oyeniyihakeem08-blip/Night-light-PCB-prototype/Night light PCB (Kicad and production files)/Design filess/Night light PCB BOM .csv

Reference | Value | DNP | Exclude from BOM | Footprint | LCSC Part #
H1,H2,H3,H4,H5 | MountingHole |  |  | MountingHole:MountingHole_3.2mm_M3
J2,J3 | Conn_ARM_SWD_TagConnect_TC2030 |  |  | Connector:Tag-Connect_TC2030-IDC-FP_2x03_P1.27mm_Vertical
J4,J5 | Conn_01x01_Pin |  |  | TestPoint:TestPoint_Keystone_5010-5014_Multipurpose
R4 | NTC |  |  | Resistor_SMD:R_0402_1005Metric
TP1 | LDO_IN |  |  | TestPoint:TestPoint_Pad_D4.0mm
U3,U5,U7,U8,U9,U10,U11,U12,U13 | mouse bite |  |  | mouse bite:mouse-bite-2mm-4mm
LED1,LED2,LED3,LED4,LED5,LED6 | SPMWH1228MD5WATUVK |  |  | LED:SPMWH1228MD5WATUVK | 1510-SPMWH1228MD7WATUVKTR-ND
BT1 | Battery |  |  | Battery:BatteryHolder_Keystone_2468_2xAAA | BC2AAAPC
C39,C55 | 1.5pf |  |  | Capacitor_SMD:C_0402_1005Metric | C1552
C40,C54 | 4.7pf |  |  | Capacitor_SMD:C_0402_1005Metric | C1569
IC1,IC5 | NRF24L01P-R |  |  | nRF24L01P:QFN50P400X400X95-21N-D | C8791
Y1,Y2 | crystal |  |  | crystal:X322516MOB4SI | C12668
Q1,Q3 | AO3407A |  |  | PMOS A03407:SOT95P280X125-3N | C15155
C31,C51 | 10nf |  |  | Capacitor_SMD:C_0402_1005Metric | C15195
Q2,Q4 | AO3400A |  |  | Package_TO_SOT_SMD:SOT-23 | C20917
R36 | 180K |  |  | Resistor_SMD:R_0402_1005Metric | C25760
C12 | 1uf |  |  | Capacitor_SMD:C_0805_2012Metric | C28323
C1 | 1uf |  |  | Capacitor_SMD:C_0402_1005Metric | C29266
C3,C6 | 100nf |  |  | Capacitor_SMD:C_0805_2012Metric | C49678
C7 | 0.1uf |  |  | Capacitor_SMD:C_0805_2012Metric | C49678
U1 | BQ24074RGT |  |  | Package_DFN_QFN:VQFN-16-1EP_3x3mm_P0.5mm_EP1.6x1.6mm | C54313
C36,C53 | 100nf |  |  | Capacitor_SMD:C_0402_1005Metric | C60474
R2,R5,R8,R9,R11,R16,R17,R18,R22,R40,R48,R49,R50,R51 | 10k |  |  | Resistor_SMD:R_0402_1005Metric | C60490
R19 | 120k |  |  | Resistor_SMD:R_0402_1005Metric | C60490
R10,R13,R29 | 100k |  |  | Resistor_SMD:R_0402_1005Metric | C60491
IC2 | TLV3012AIDBVTG4 |  |  | TLV3012:SOT95P280X145-6N | C62505
C28,C50 | 1nf |  |  | Capacitor_SMD:C_0402_1005Metric | C76947
L6,L8 | 2.7nH |  |  | Inductor_SMD:L_0402_1005Metric | C77108
R6,R21 | 22k |  |  | Resistor_SMD:R_0402_1005Metric | C82868
R52 | 330r |  |  | Resistor_SMD:R_0402_1005Metric | C84256
L4,L7 | 8.2nH |  |  | Inductor_SMD:L_0402_1005Metric | C84404
C2 | 1nf |  |  | Capacitor_SMD:C_0805_2012Metric | C94121
C14 | 10uf |  |  | Capacitor_SMD:C_0805_2012Metric | C95841
C5,C8,C9,C11 | 4.7uf |  |  | Capacitor_SMD:C_0805_2012Metric | C98192
R7 | 4k7 |  |  | Resistor_SMD:R_0402_1005Metric | C105871
R15 | 100r |  |  | Resistor_SMD:R_0402_1005Metric | C106232
R38 | 100R |  |  | Resistor_SMD:R_0402_1005Metric | C106232
C16,C47 | 33nf |  |  | Capacitor_SMD:C_0402_1005Metric | C106862
R20 | R_Photo |  |  | OptoDevice:R_LDR_5.0x4.1mm_P3mm_Vertical | C125627
C10 | 220uf |  |  | Capacitor_SMD:C_Elec_6.3x7.7 | C125977
F1 | JFC2410-1100TS |  |  | FUSE:FUSC10131X330N | C136380
R27,R35 | 6.2k |  |  | Resistor_SMD:R_0402_1005Metric | C137946
R39 | 470k |  |  | Resistor_SMD:R_0402_1005Metric | C137976
R41,R42,R43,R44,R45,R46 | 33R |  |  | Resistor_SMD:R_0805_2012Metric | C138002
R1 | 2.7K |  |  | Resistor_SMD:R_0402_1005Metric | C138017
R14,R26,R32,R33,R47 | 1M |  |  | Resistor_SMD:R_0402_1005Metric | C138033
R23,R24,R25,R28,R30 | 18k |  |  | Resistor_SMD:R_0402_1005Metric | C138044
FL2 | UU9.8-10MH |  |  | 10MH CHOKE:UU9810MH | C148474
J1 | Battery |  |  | Connector_JST:JST_EH_B2B-EH-A_1x02_P2.50mm_Vertical | C160262
R3 | 1.8K |  |  | Resistor_SMD:R_0402_1005Metric | C163481
R31 | 2.2M |  |  | Resistor_SMD:R_0402_1005Metric | C203143
PS1 | HLK-5M05 |  |  | Converter_ACDC:Converter_ACDC_Hi-Link_HLK-5Mxx | C209907
C23,C25,C48,C49 | 22pf |  |  | Capacitor_SMD:C_0402_1005Metric | C277482
C37 | 103pf |  |  | Capacitor_SMD:C_0402_1005Metric | C327009
U4 | TLV75533PDBV |  |  | Package_TO_SOT_SMD:SOT-23-5 | C404027
R34 | 3.3M |  |  | Resistor_SMD:R_0402_1005Metric | C482174
U2 | ATtiny1616-S |  |  | Package_SO:SOIC-20W_7.5x12.8mm_P1.27mm | C614136
C34,C44,C45 | 470pf |  |  | Capacitor_SMD:C_0402_1005Metric | C701296
C42,C56 | 1pf |  |  | Capacitor_SMD:C_0402_1005Metric | C710646
IC4 | STM32G031K8T6TR |  |  | STM32:QFP80P900X900X160-32N | C724044
VR1 | PVG3A103C01R00 |  |  | 10k trimmer:PVG3A103C01R00 | C780220
RV1 | Varistor |  |  | Varistor:RV_Disc_D12mm_W4.5mm_P7.5mm | C2839517
C19 | 10uf |  |  | Capacitor_SMD:C_1210_3225Metric | C2918502
C43,C52 | 2.2nf |  |  | Capacitor_SMD:C_0402_1005Metric | C2987940
R37 | 4.7M |  |  | Resistor_SMD:R_0402_1005Metric | C3013173
R12 | 174k |  |  | Resistor_SMD:R_0402_1005Metric | C4214842
S1,S2,S3 | 1301.9314.24 |  |  | Switch:1301931424 | C4364459
C21,C26,C35,C41 | 47uf |  |  | Capacitor_SMD:C_1210_3225Metric | C5440143
L5,L9 | 3.9nH |  |  | Inductor_SMD:L_0402_1005Metric | C5452416
IC3 | BISS0001 |  |  | BISS0001:SOIC127P600X160-16N | C18164474
C22 | 510pf |  |  | Capacitor_SMD:C_0402_1005Metric | C18185763
D1 | LED |  |  | LED_SMD:LED_0402_1005Metric | C21260817
C30,C38 | 56nf |  |  | Capacitor_SMD:C_0402_1005Metric | C36911349
C46 | 56nF |  |  | Capacitor_SMD:C_0402_1005Metric | C36911349
C4 | 0.1 |  |  | Capacitor_THT:C_Rect_L13.0mm_W8.0mm_P10.00mm_FKS3_FKP3_MKS4 | C46638858
U6 | PIS-209S |  |  | PIS209S:PIS209S | https://www.jotrin.com/product/parts/PIS209S
