oyeniyihakeem08-blip/Night-light-PCB-prototype/3D Model/2468.step

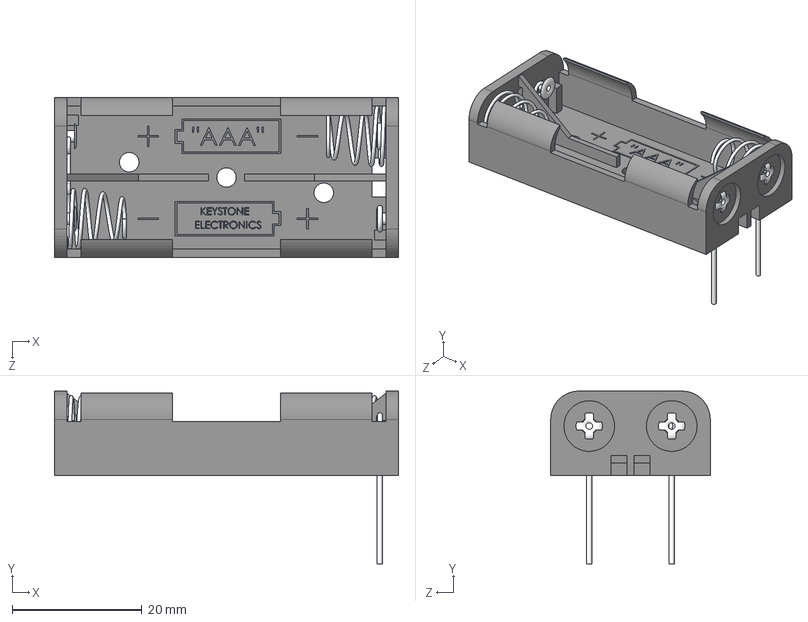
[picture p8: CAD file, 2026-05-13]
3D Model/2468.step
53.0 x 26.6 x 24.6 mm
