oyeniyihakeem08-blip/Night-light-PCB-prototype/Design filess/Night light PCB 3D model/Night Light board.step

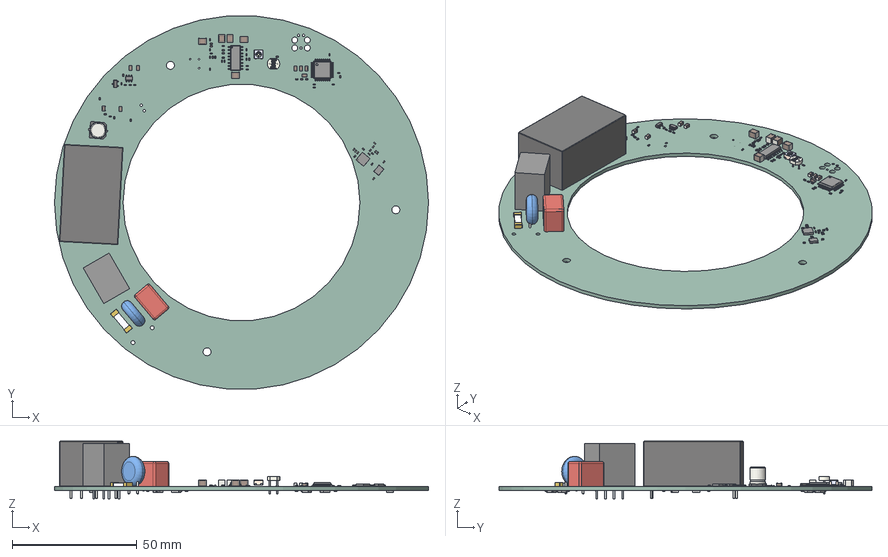
[picture p9: CAD file, 2026-05-13]
Design filess/Night light PCB 3D model/Night Light board.step
150.0 x 149.6 x 23.1 mm
R_0402_1005Metric x 40
C_0402_1005Metric x 19
L_0402_1005Metric x 3
C_0805_2012Metric x 8
Converter_ACDC_Hi-Link_HLK-5Mxx
C_1210_3225Metric x 5
ThermalPin
PinsArrayLR x 3
PinsArrayTB x 2
BODY-SOT
LEAD-SOT x 6
RV_Disc_D12mm_W4.5mm_P7.5mm
Leads x 4
C_Elec_6.3x7.7
Pins
10k pot PVG3A103C01R00
SOT-23
fuse SF-3812TL100T-2
C_Rect_L13.0mm_W8.0mm_P10.00mm_FKS3_FKP3_MKS4
R_LDR_5.0x4.1mm_P3mm_Vertical
LED SPMWH1228MD5WATUVK x 6
Night light PCB_PCB
