oyeniyihakeem08-blip/Night-light-PCB-prototype/Night light PCB (Kicad and production files)/Design filess/Night light PCB 3D model/Night Light remote board.step

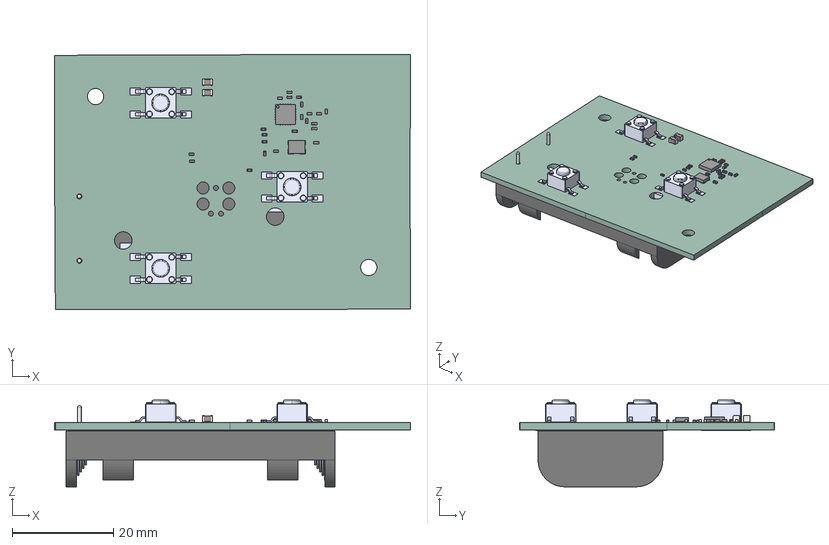
[picture p10: CAD file, 2026-05-13]
Night light PCB (Kicad and production files)/Design filess/Night light PCB 3D model/Night Light remote board.step
70.2 x 50.2 x 17.1 mm
L_0402_1005Metric x 3
R_0402_1005Metric x 9
Pins
C_0402_1005Metric x 10
Switch 1301.9314.24 x 3
C_0805_2012Metric x 2
ThermalPin
PinsArrayLR
PinsArrayTB
BatteryHolder_Keystone_2468_2xAAA
Night light PCB_PCB
