oyeniyihakeem08-blip/Night-light-PCB-prototype/3D Model/fuse  SF-3812TL100T-2.stp

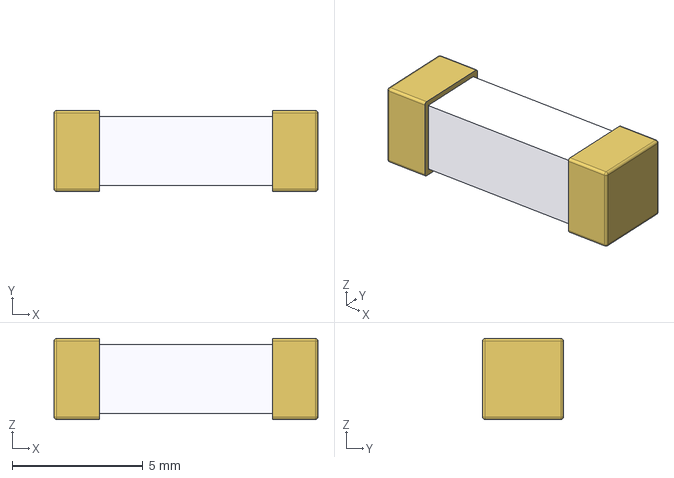
[picture p11: CAD file, 2026-04-28]
3D Model/fuse SF-3812TL100T-2.stp
10.1 x 3.10 x 3.10 mm
