oyeniyihakeem08-blip/Night-light-PCB-prototype/Night light PCB (Kicad and production files)/Design filess/Night light PCB 3D model/Night light PCB.step

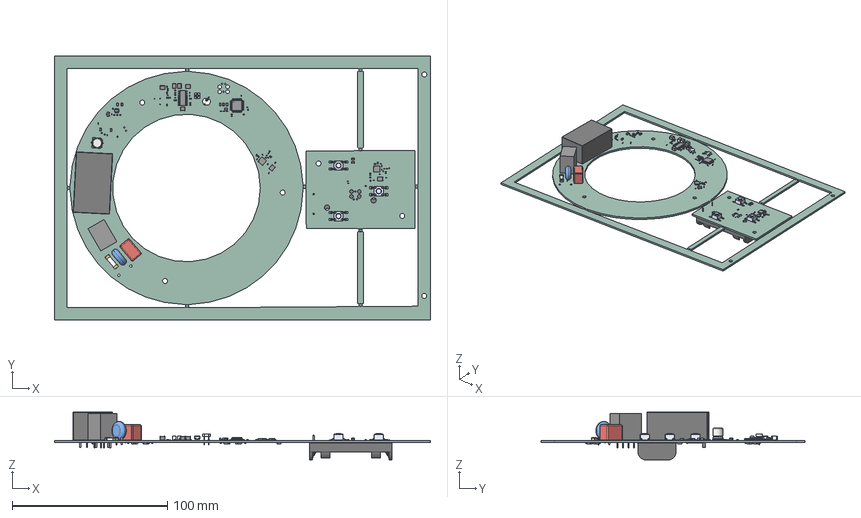
[picture p12: CAD file, 2026-04-28]
Night light PCB (Kicad and production files)/Design filess/Night light PCB 3D model/Night light PCB.step
242.1 x 170.0 x 30.9 mm
R_0402_1005Metric x 49
C_0402_1005Metric x 29
L_0402_1005Metric x 6
C_0805_2012Metric x 10
Converter_ACDC_Hi-Link_HLK-5Mxx
C_1210_3225Metric x 5
ThermalPin x 2
PinsArrayLR x 4
PinsArrayTB x 3
Pins x 2
BODY-SOT
LEAD-SOT x 6
Switch 1301.9314.24 x 3
RV_Disc_D12mm_W4.5mm_P7.5mm
Leads x 4
C_Elec_6.3x7.7
10k pot PVG3A103C01R00
SOT-23
fuse SF-3812TL100T-2
C_Rect_L13.0mm_W8.0mm_P10.00mm_FKS3_FKP3_MKS4
R_LDR_5.0x4.1mm_P3mm_Vertical
LED SPMWH1228MD5WATUVK x 6
BatteryHolder_Keystone_2468_2xAAA
Night light PCB_PCB
