oyeniyihakeem08-blip/Night-light-PCB-prototype/3D Model/STM32G031K8T6TR.stp

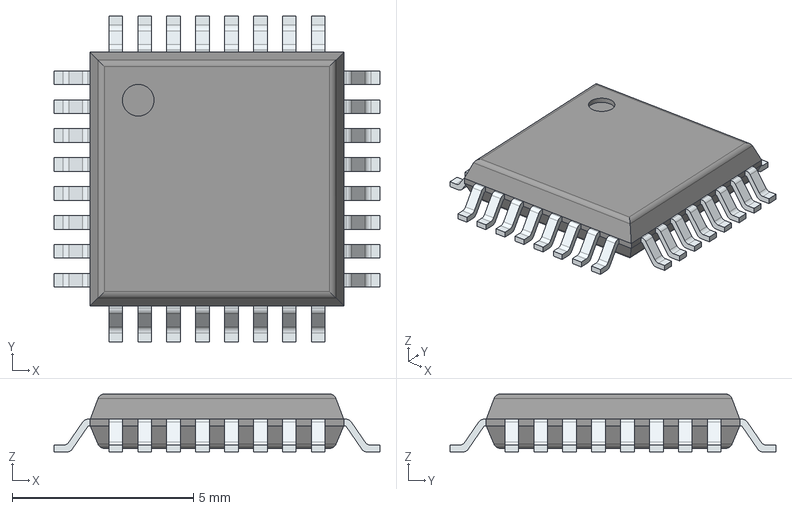
[picture p13: CAD file, 2026-04-28]
3D Model/STM32G031K8T6TR.stp
9.00 x 9.00 x 1.60 mm
PinsArrayLR
PinsArrayTB
