oyeniyihakeem08-blip/Night-light-PCB-prototype/3D Model/NRF24L01P-R.stp

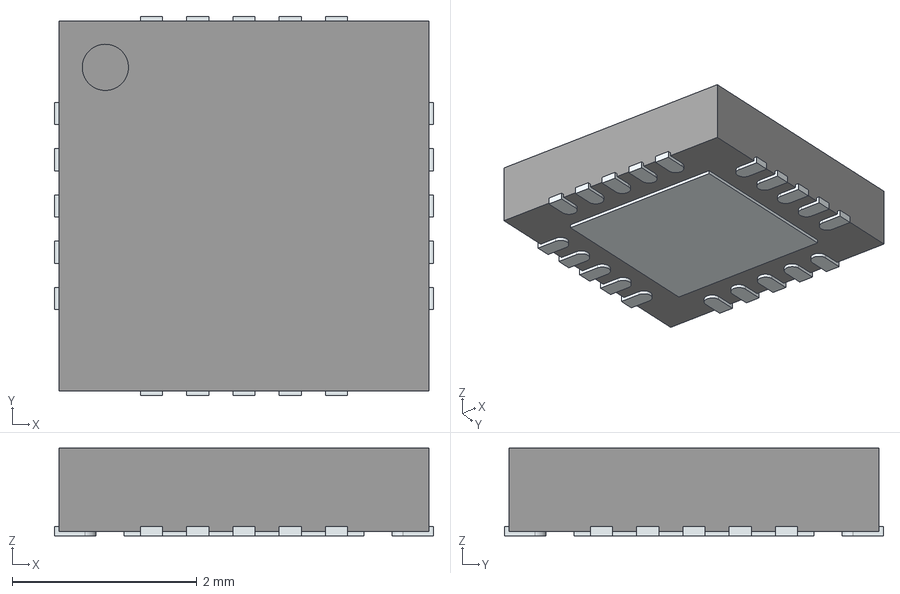
[picture p14: CAD file, 2026-04-28]
3D Model/NRF24L01P-R.stp
4.10 x 4.10 x 0.95 mm
ThermalPin
PinsArrayLR
PinsArrayTB
