oyeniyihakeem08-blip/Night-light-PCB-prototype/3D Model/Switch  1301.9314.24.stp

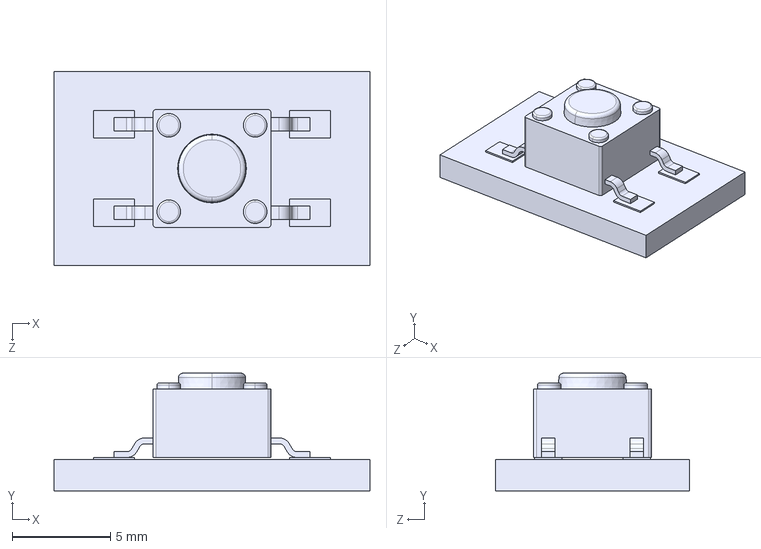
[picture p15: CAD file, 2026-04-28]
3D Model/Switch 1301.9314.24.stp
16.1 x 6.00 x 9.90 mm
