oyeniyihakeem08-blip/Night-light-PCB-prototype/3D Model/TLV3012AIDBVTG4.stp

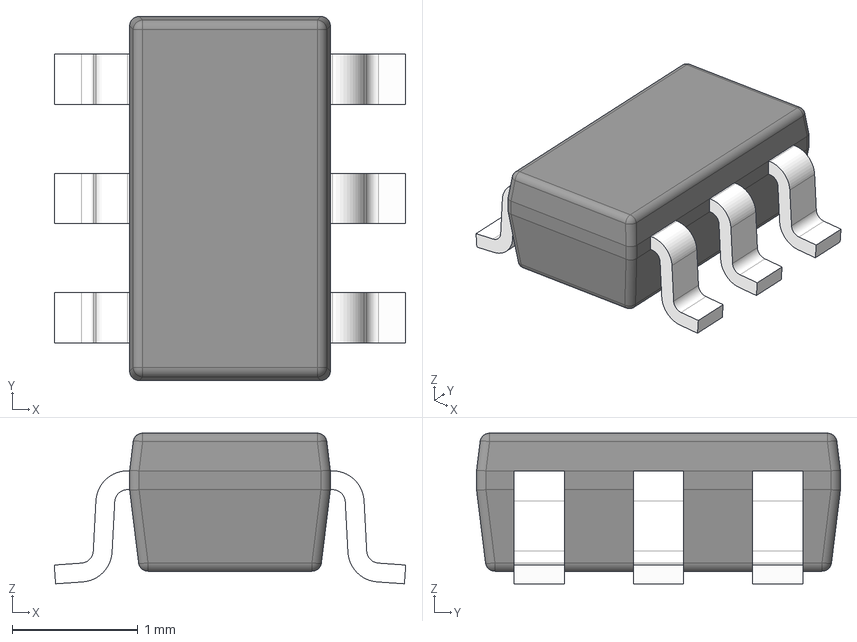
[picture p16: CAD file, 2026-04-28]
3D Model/TLV3012AIDBVTG4.stp
2.80 x 2.90 x 1.20 mm
BODY-SOT
LEAD-SOT x 6
