oyeniyihakeem08-blip/Night-light-PCB-prototype/3D Model/crystal  X322516MOB4SI.stp

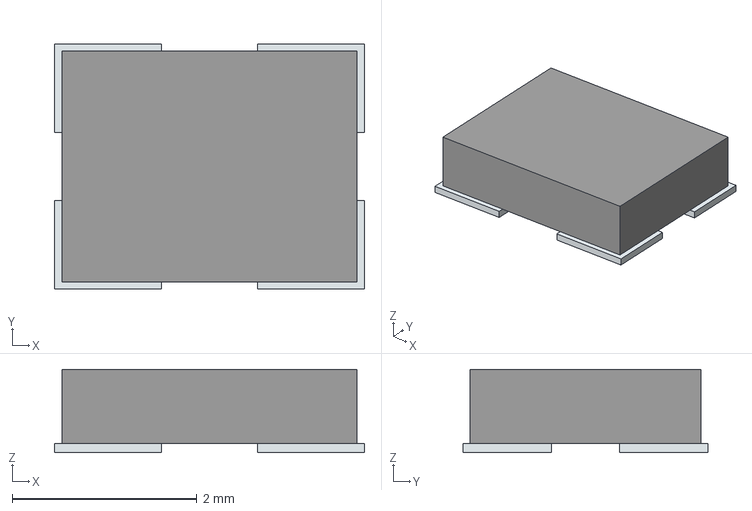
[picture p17: CAD file, 2026-04-28]
3D Model/crystal X322516MOB4SI.stp
3.36 x 2.66 x 0.9 mm
Pins
