oyeniyihakeem08-blip/Night-light-PCB-prototype/3D Model/UU9.8-10MH.stp

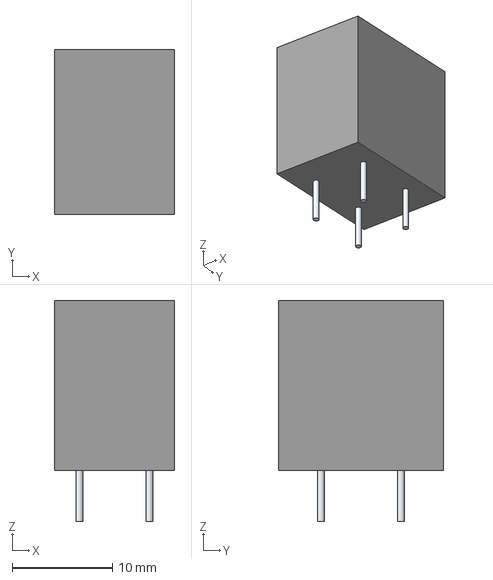
[picture p18: CAD file, 2026-04-28]
3D Model/UU9.8-10MH.stp
12.0 x 16.5 x 22.1 mm
Leads x 4
