oyeniyihakeem08-blip/Night-light-PCB-prototype/3D Model/LED  SPMWH1228MD5WATUVK.stp

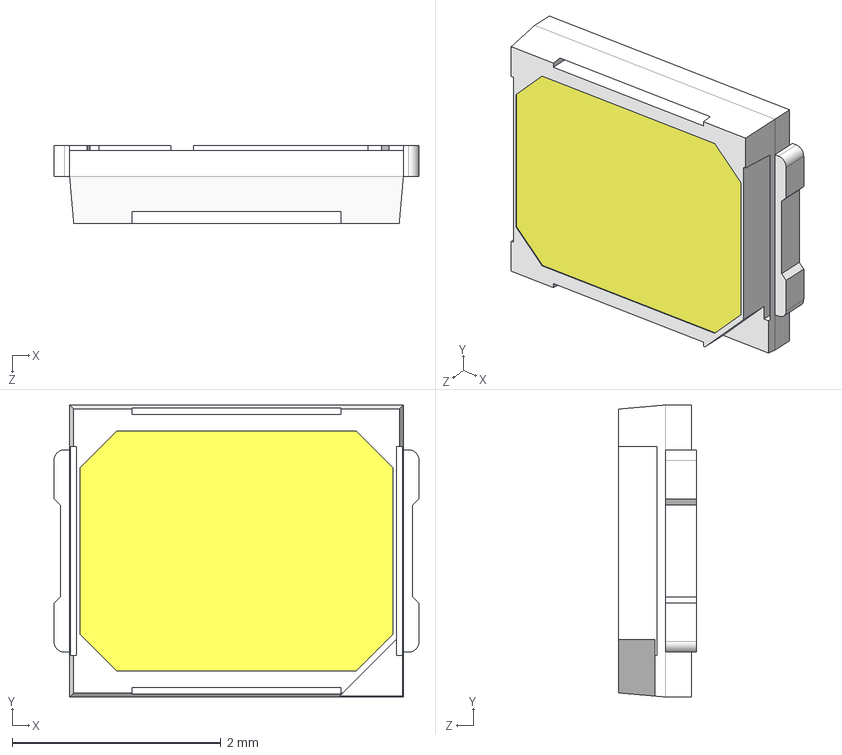
[picture p19: CAD file, 2026-04-28]
3D Model/LED SPMWH1228MD5WATUVK.stp
3.50 x 2.80 x 0.75 mm
