oyeniyihakeem08-blip/Night-light-PCB-prototype/3D Model/10k pot PVG3A103C01R00.stp

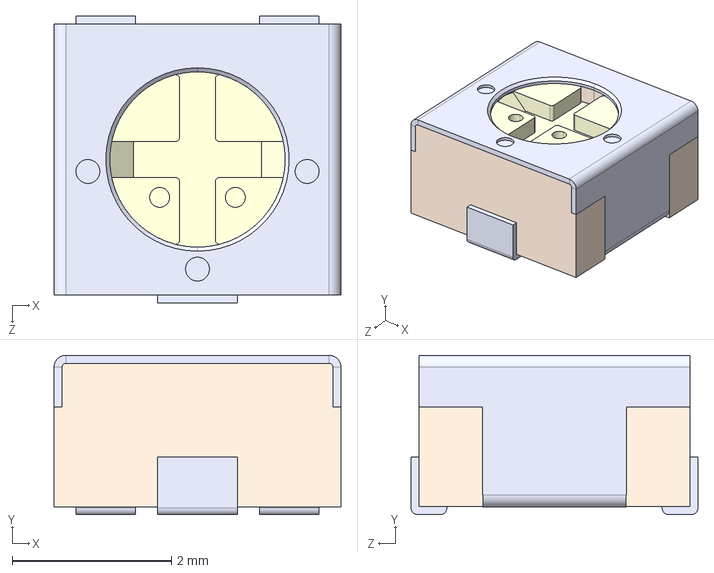
[picture p20: CAD file, 2026-04-22]
3D Model/10k pot PVG3A103C01R00.stp
3.60 x 2.00 x 3.60 mm
