oyeniyihakeem08-blip/Night-light-PCB-prototype/3D Model/BISS0001.stp

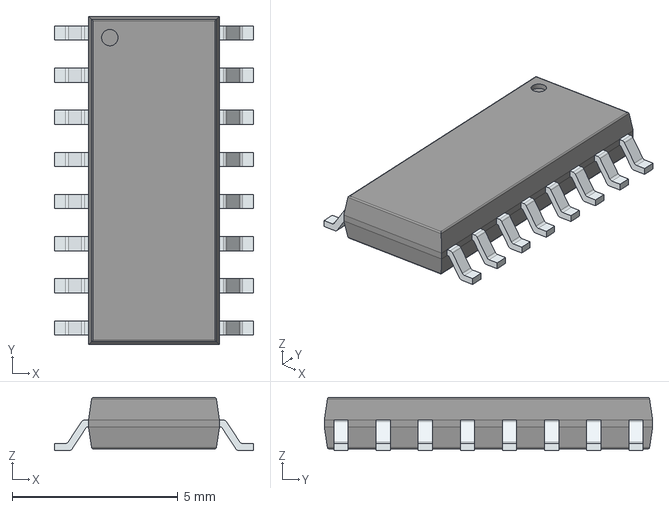
[picture p21: CAD file, 2026-04-22]
3D Model/BISS0001.stp
6.00 x 9.90 x 1.60 mm
PinsArrayLR
