oyeniyihakeem08-blip/Night-light-PCB-prototype/3D Model/PMOS-AO3407A.stp

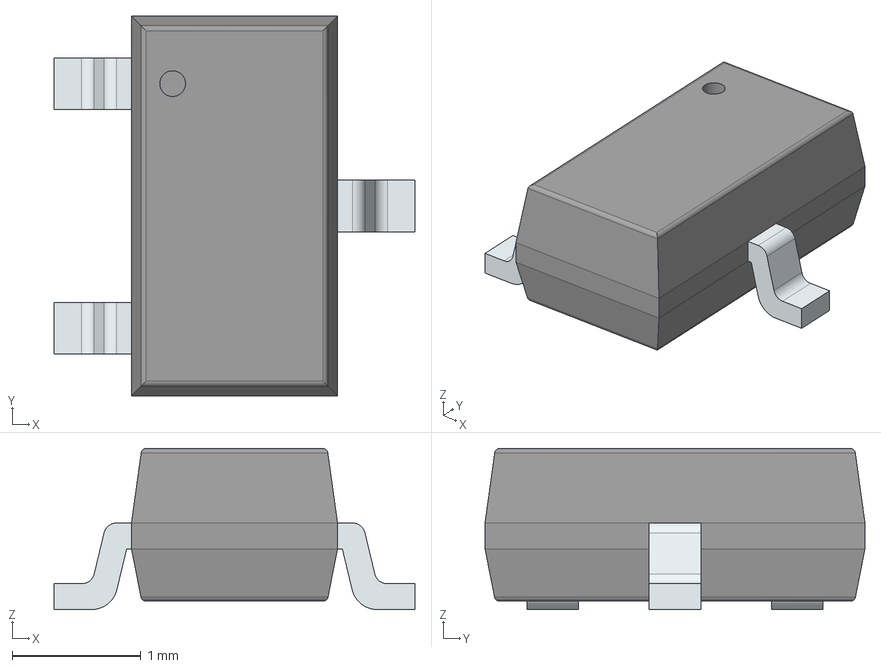
[picture p22: CAD file, 2026-04-22]
3D Model/PMOS-AO3407A.stp
2.80 x 2.95 x 1.25 mm
PinsArrayL
FilletPinR
