oyeniyihakeem08-blip/Night-light-PCB-prototype/3D Model/PIS-209S.stp

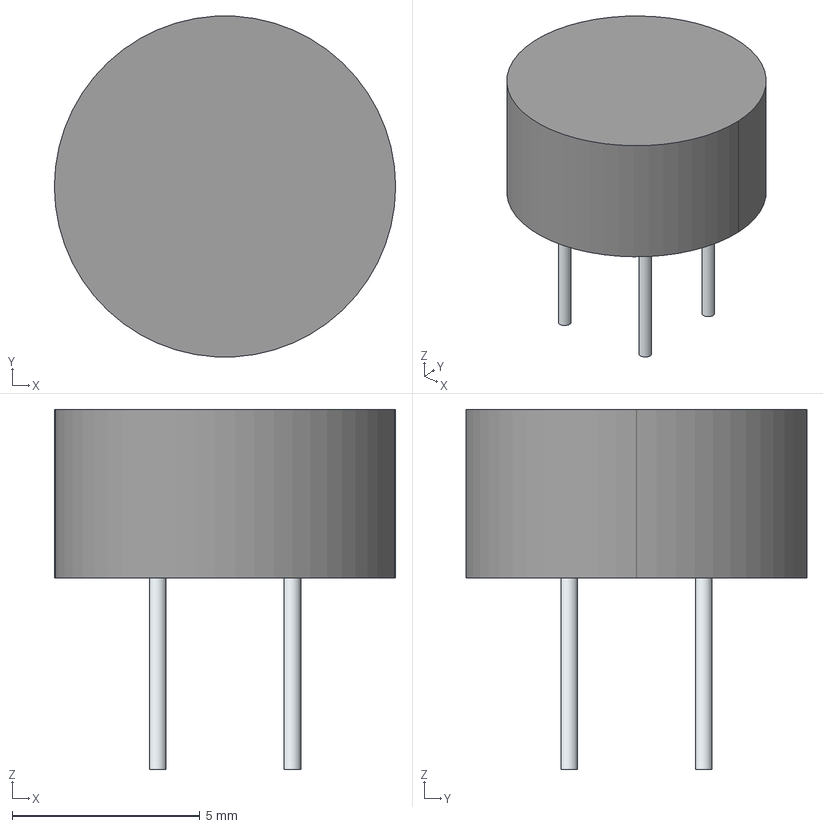
[picture p23: CAD file, 2026-04-22]
3D Model/PIS-209S.stp
9.10 x 9.08 x 9.60 mm
Leads
