oyeniyihakeem08-blip/Night-light-PCB-prototype/3D Model/10 mh choke RN112-0.8-02-10M.stp

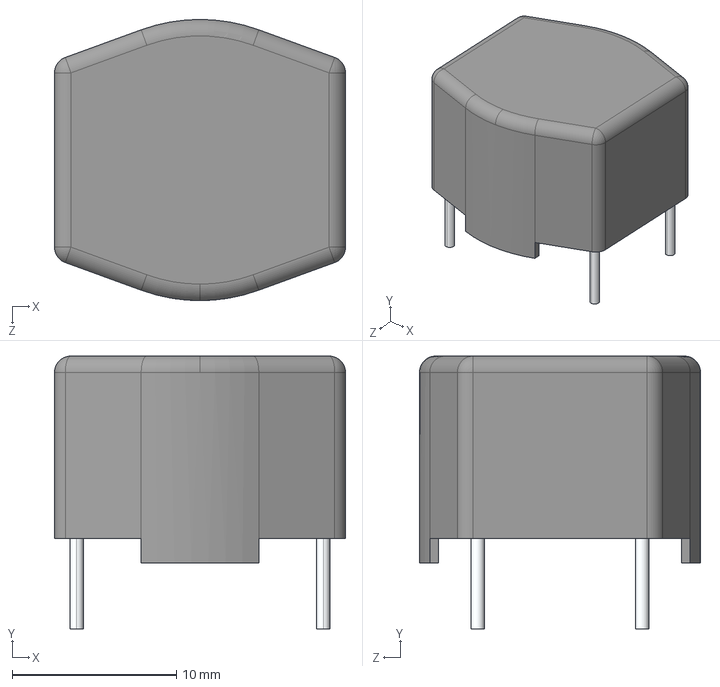
[picture p24: CAD file, 2026-04-22]
3D Model/10 mh choke RN112-0.8-02-10M.stp
17.7 x 16.6 x 17.1 mm
