oyeniyihakeem08-blip/Night-light-PCB-prototype/3D Model/AA bat BC2AAPC.stp

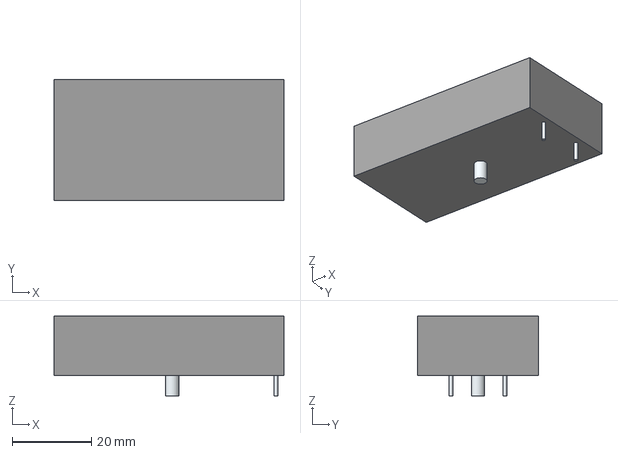
[picture p25: CAD file, 2026-04-22]
3D Model/AA bat BC2AAPC.stp
58.0 x 30.5 x 20.1 mm
Leads x 3
