oyeniyihakeem08-blip/Night-light-PCB-prototype/firmwares/Night light Firmware/Bulb firmware/Flashing instruction.pdf

Flashing Instructions – STM32G031 (Smart Bulb)

Method: ST-Link

Tools Required:

* ST-Link programmer

* STM32CubeProgrammer software (install on PC)

Steps:

1. Connect ST-Link to the board:

* SWDIO → SWDIO

* SWCLK → SWCLK

* GND → GND

* 3.3V → VCC (if required)

2. Power the board.
3. Open STM32CubeProgrammer.
4. Select "ST-Link" as the connection type.
5. Click "Connect".
6. Load the firmware:

* Click "Open File"

* Select firmware.bin

7. Set the start address:

0x08000000

8. Click "Download" or "Start Programming".
9. Wait until flashing completes.
10. Reset the board.

Result:

The firmware should now be running on the device.
