oyeniyihakeem08-blip/Night-light-PCB-prototype/firmwares/Night light Firmware/Remote fimware/Flashing Instructions  ATtiny1616.pdf

Flashing Instructions ATtiny1616 (Remote)

Method: UPDI using Arduino IDE

Tools Required:

* Arduino IDE installed

* UPDI programmer OR Arduino configured as UPDI programmer

Steps:

1. Connect UPDI:

* UPDI pin → programmer UPDI

* GND → GND

* VCC → 3.3V or 5V (as required)

2. Open Arduino IDE.
3. Install megaTinyCore (if not already installed).
4. Select Board:

ATtiny1616

5. Select Programmer:

"SerialUPDI" or equivalent

6. Load firmware:

* Use "Sketch → Upload Using Programmer"

* Select the firmware.hex file

7. Wait for upload to complete.

Result:

Firmware is now programmed into the ATtiny1616.
