oyeniyihakeem08-blip/Night-light-PCB-prototype/Night light Schematics.pdf

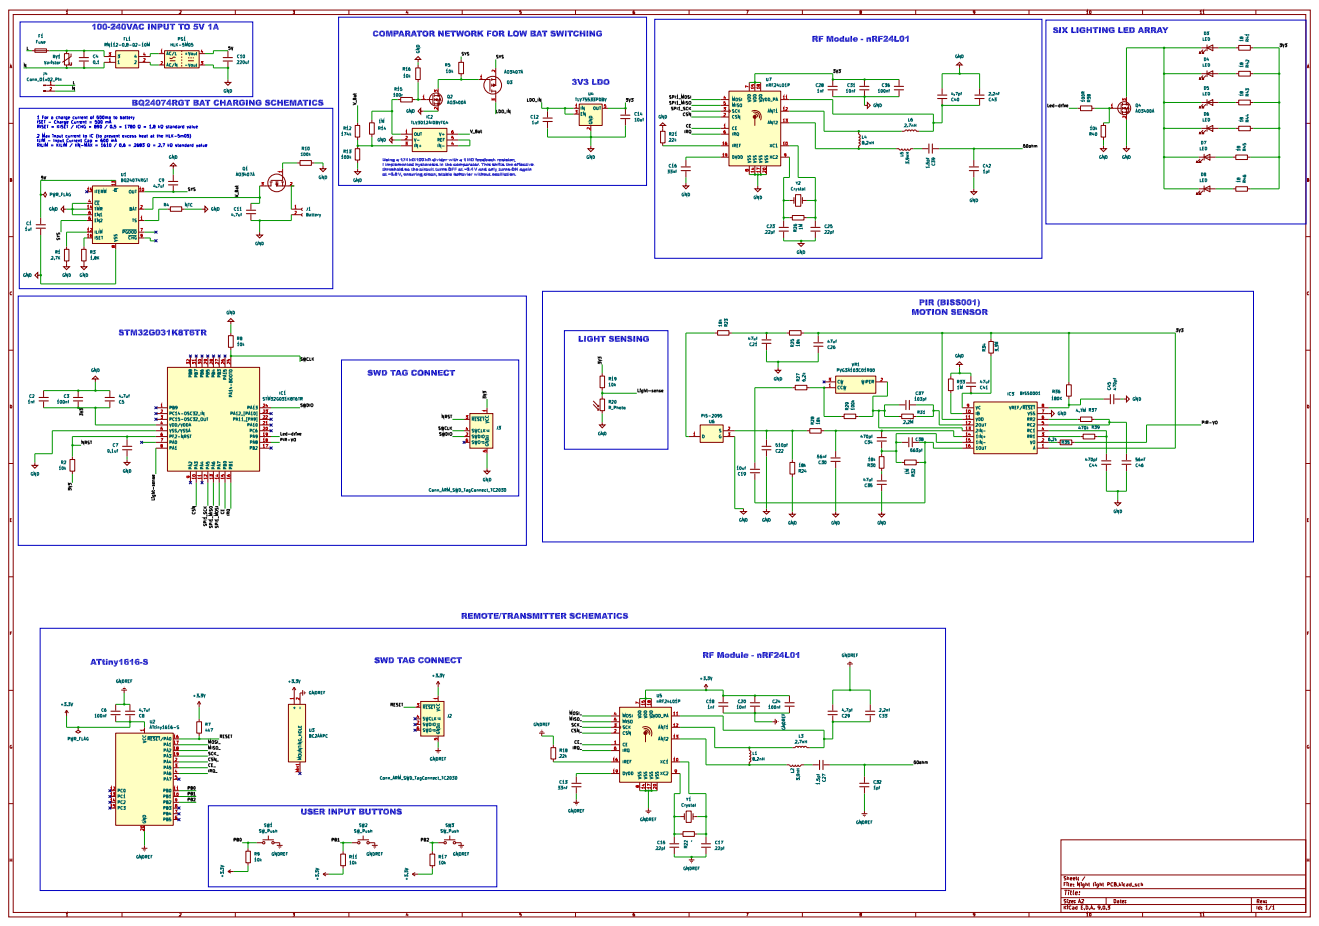
[picture p26: page 1]
