oyeniyihakeem08-blip/Night-light-PCB-prototype/Design filess/Night light Schematics.pdf

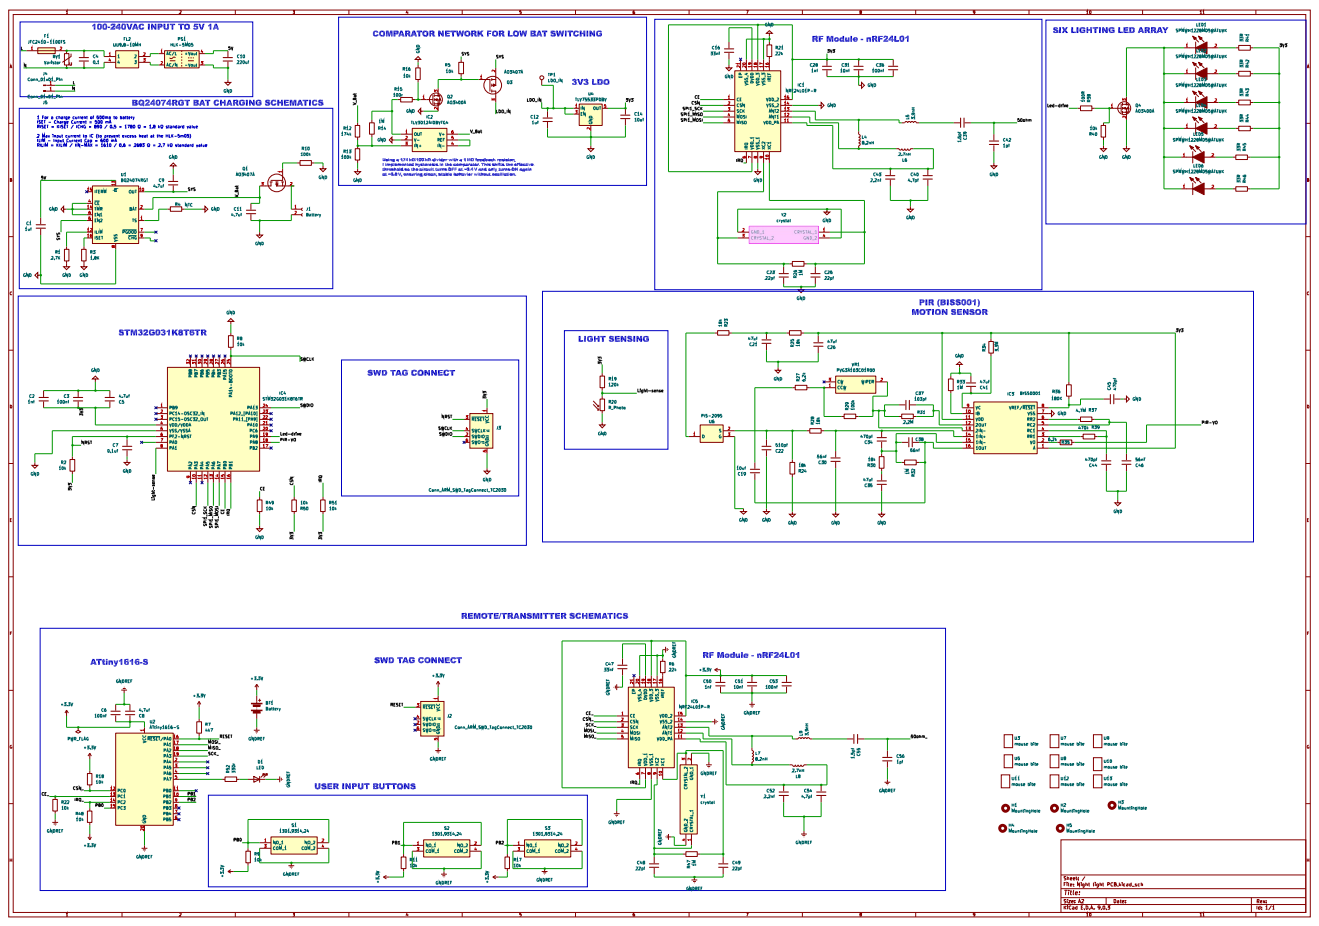
[picture p27: page 1]
