oyeniyihakeem08-blip/Night-light-PCB-prototype/Night light PCB-F_Fab.pdf

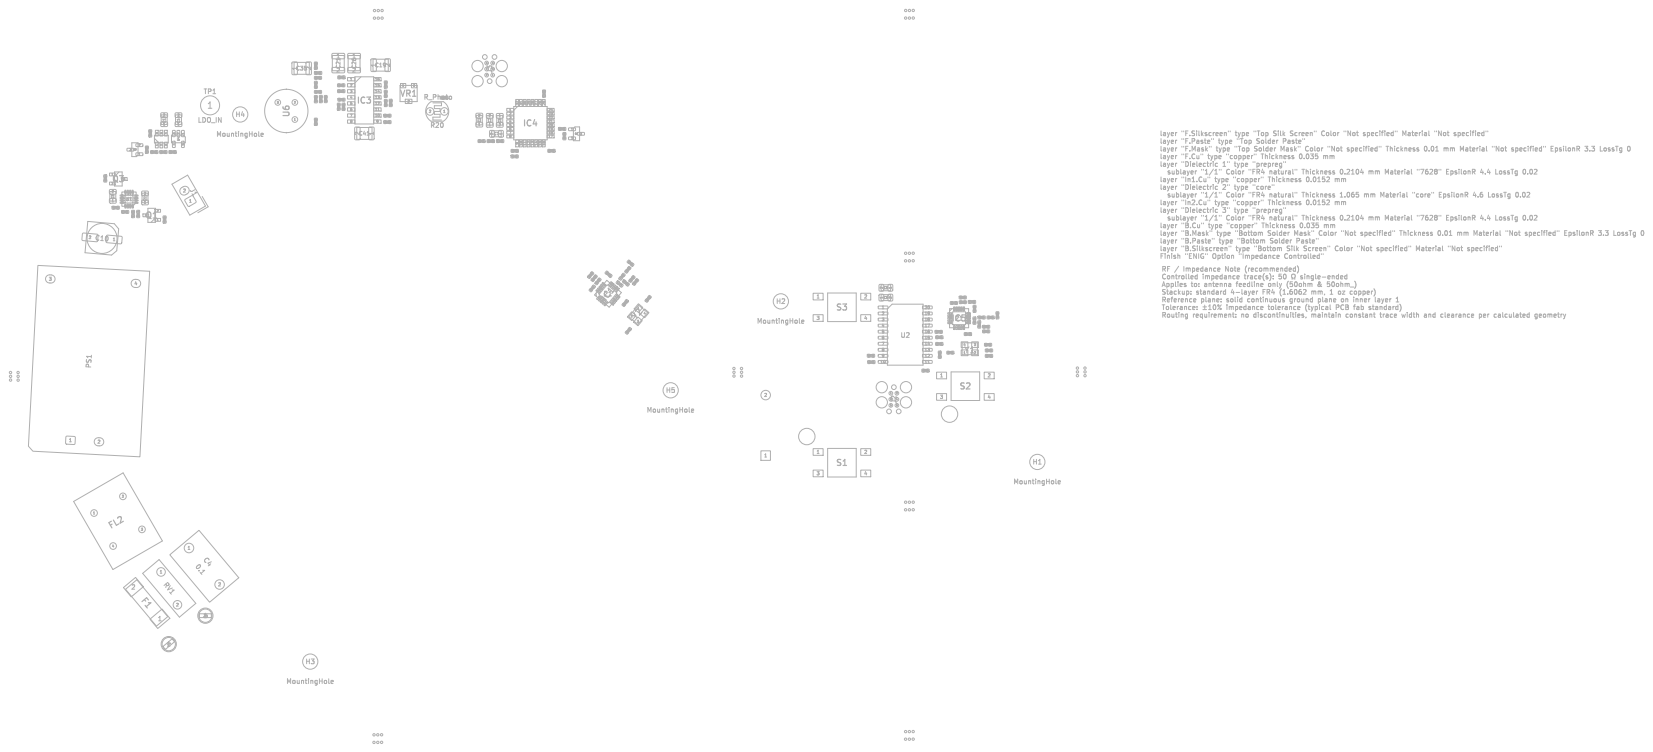
[picture p28: page 1]
