oyeniyihakeem08-blip/Night-light-PCB-prototype/Night light PCB.pdf

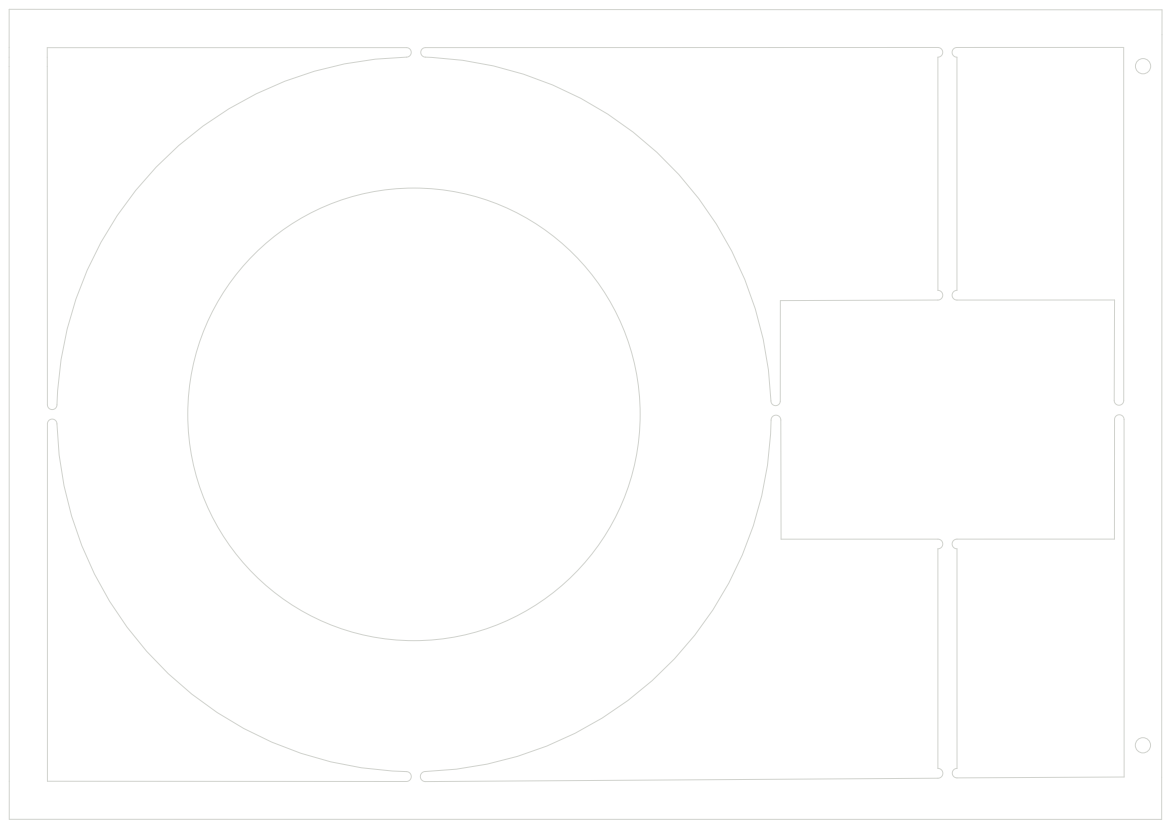
[picture p29: page 1]
