oyeniyihakeem08-blip/Night-light-PCB-prototype/Night light PCB.kicad_pcb

## KiCad design Night light PCB.kicad_pcb (2026-05-13)

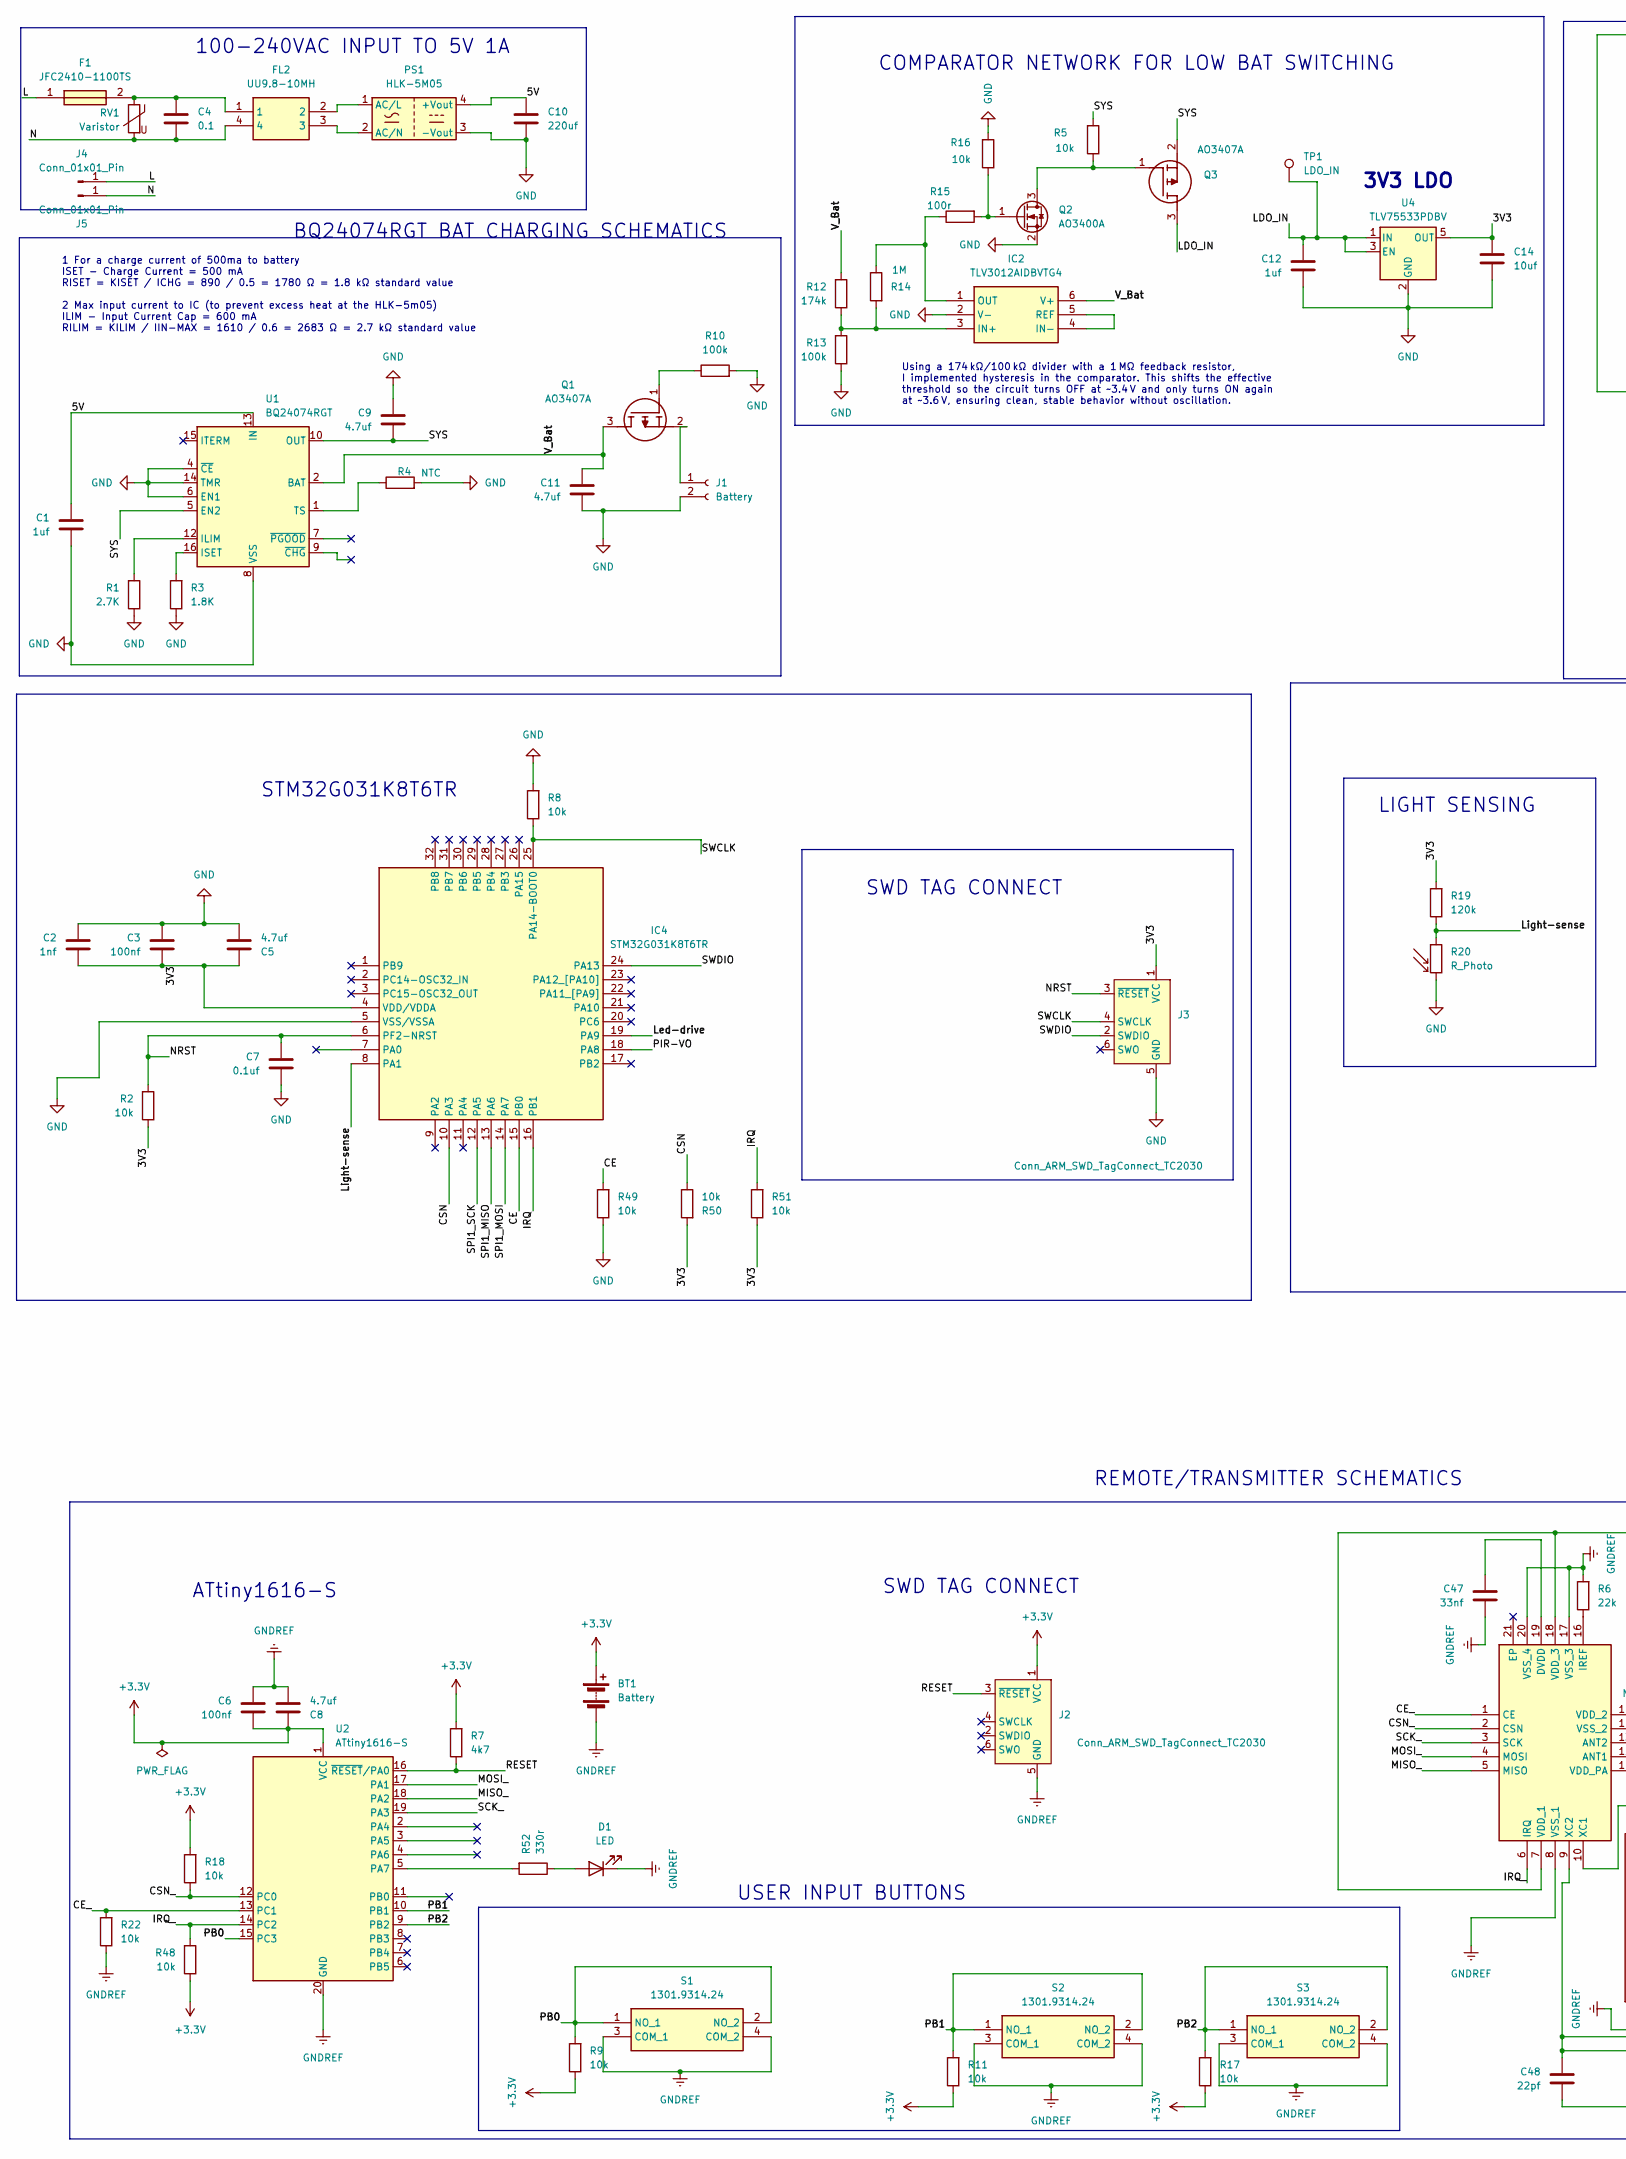
[picture p30: schematic Night light PCB.kicad_sch, part in row 1, column 1]

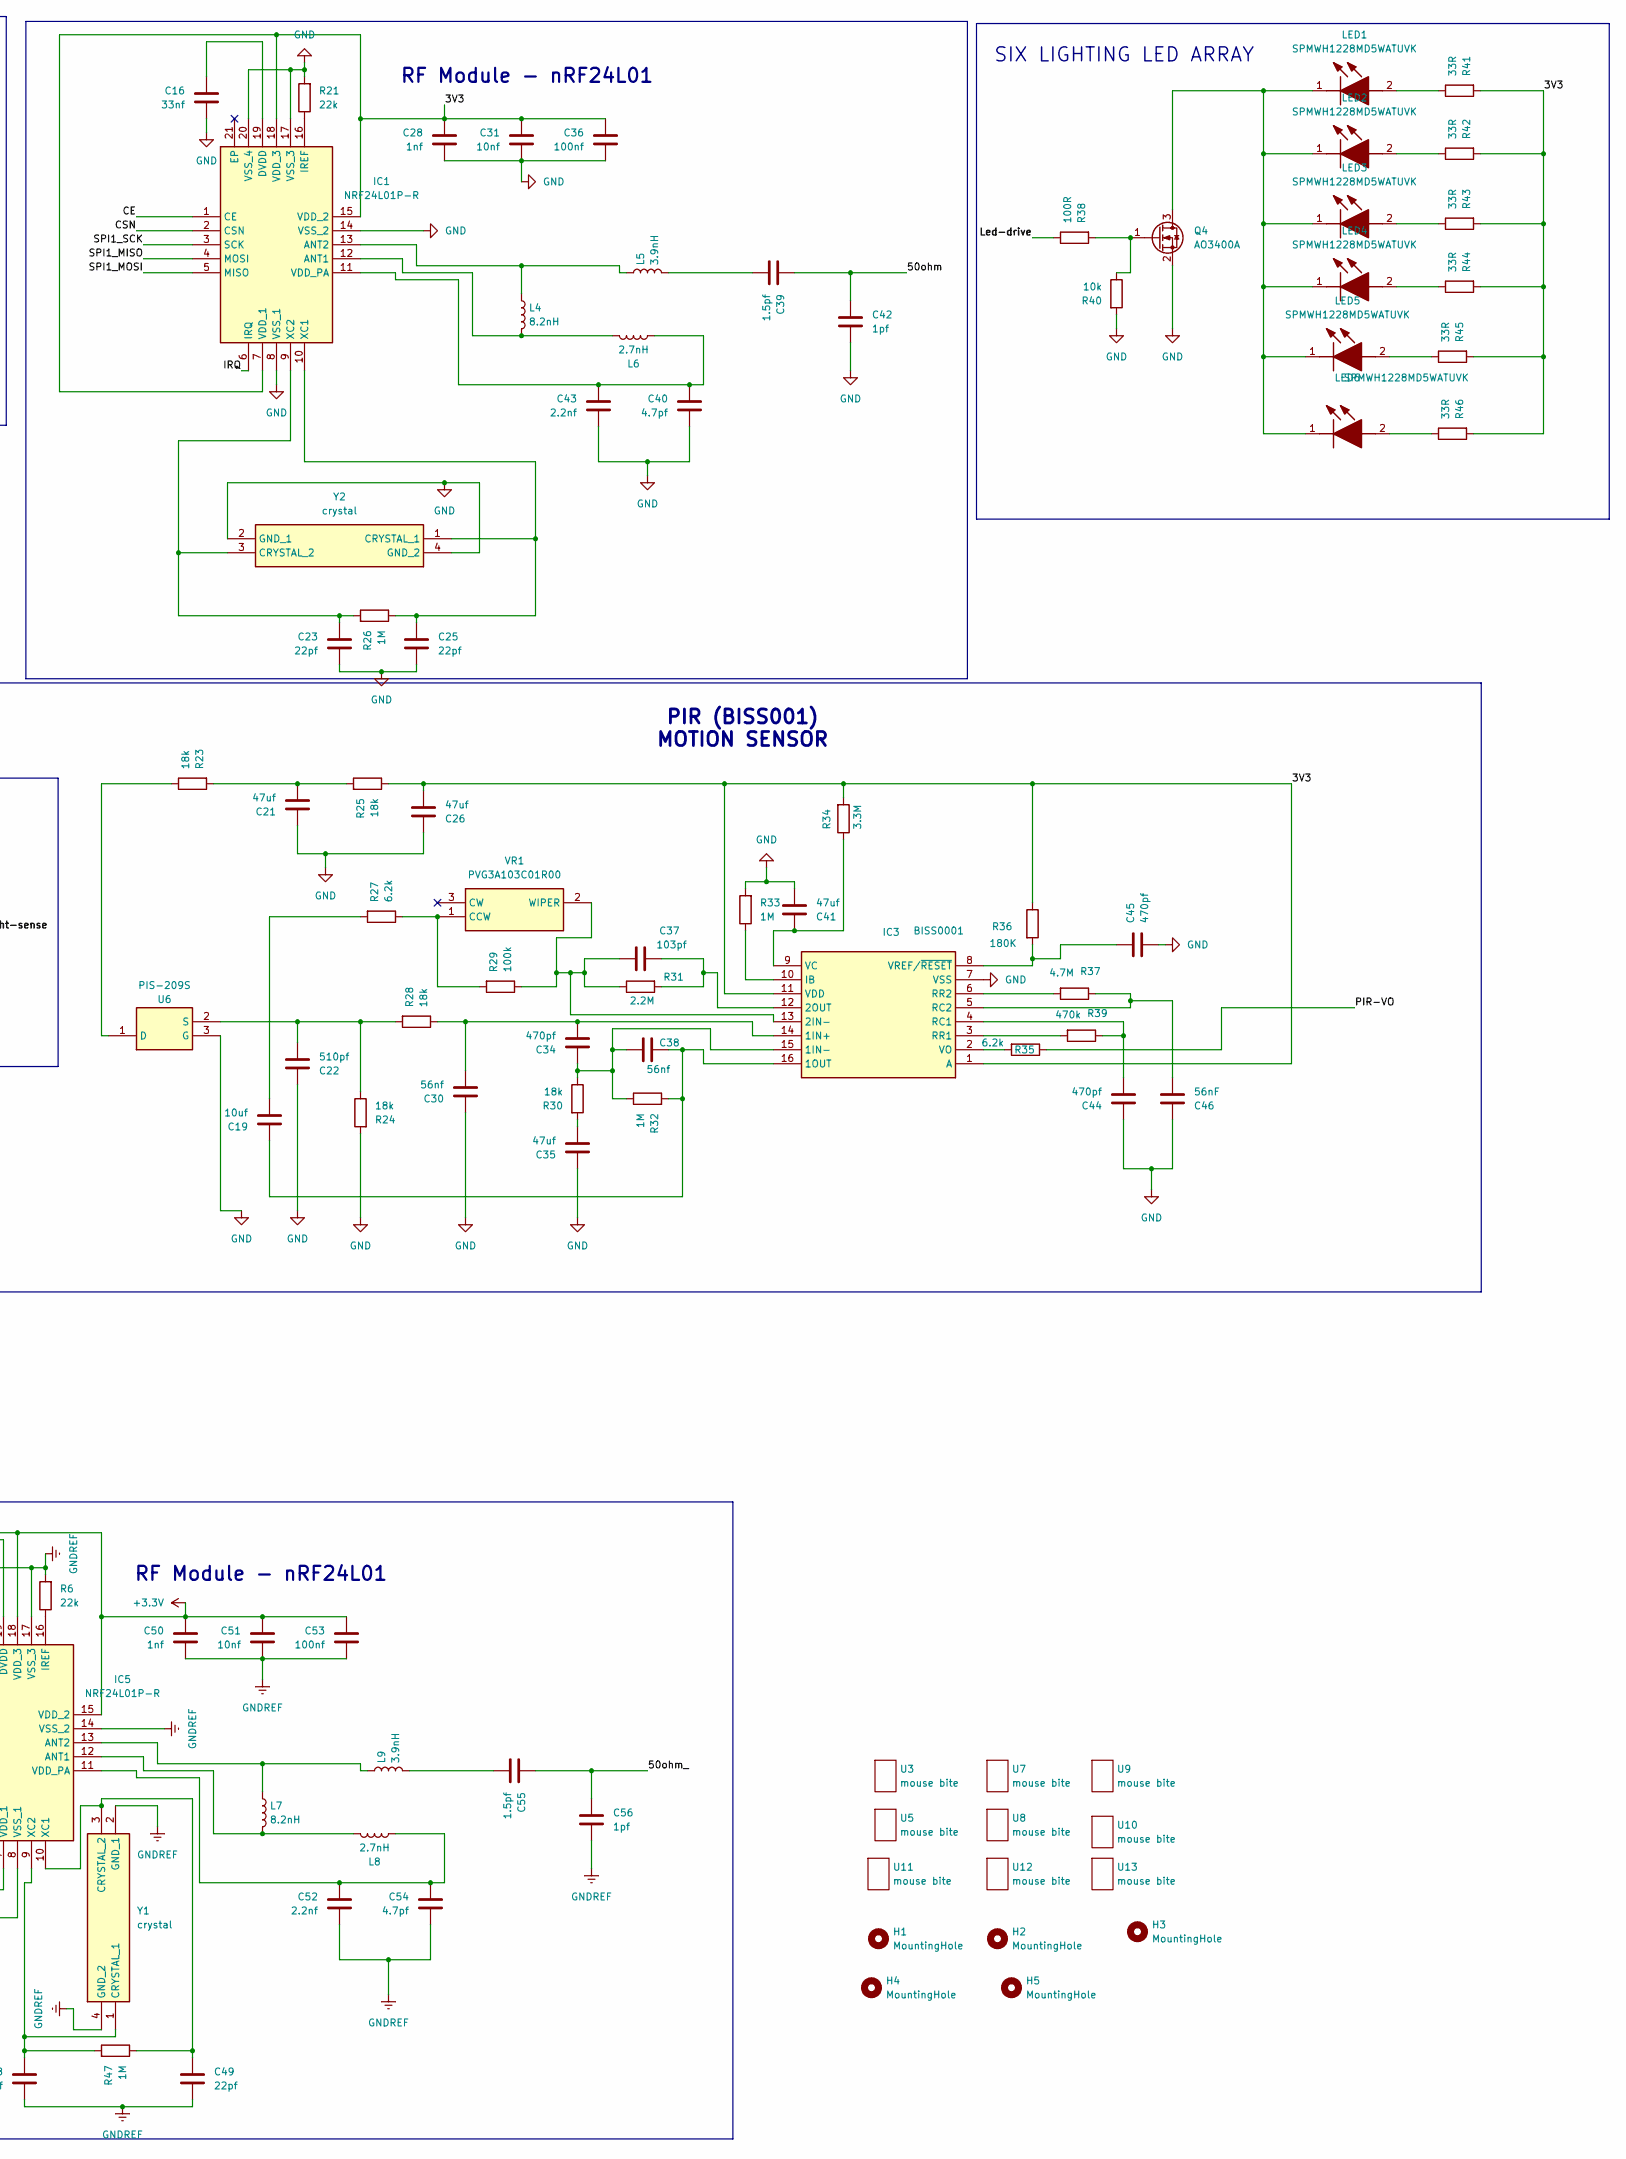
[picture p31: schematic Night light PCB.kicad_sch, part in row 1, column 2]

Parts:
BT1: Battery; BatteryHolder_Keystone_2468_2xAAA; LCSC Part # BC2AAAPC
C1: 1uf; C_0402_1005Metric; LCSC Part # C29266
C2: 1nf; C_0805_2012Metric; LCSC Part # C94121
C3, C6: 100nf; C_0805_2012Metric; LCSC Part # C49678
C4: 0.1; C_Rect_L13.0mm_W8.0mm_P10.00mm_FKS3_FKP3_MKS4; LCSC Part # C46638858
C5, C8, C9, C11: 4.7uf; C_0805_2012Metric; LCSC Part # C98192
C7: 0.1uf; C_0805_2012Metric; LCSC Part # C49678
C10: 220uf; C_Elec_6.3x7.7; LCSC Part # C2887273
C12: 1uf; C_0805_2012Metric; LCSC Part # C28323
C14: 10uf; C_0805_2012Metric; LCSC Part # C95841
C16, C47: 33nf; C_0402_1005Metric; LCSC Part # C106862
C19: 10uf; C_1210_3225Metric; LCSC Part # C2918502
C21, C26, C35, C41: 47uf; C_1210_3225Metric; LCSC Part # C5440143
C22: 510pf; C_0402_1005Metric; LCSC Part # C18185763
C23, C25, C48, C49: 22pf; C_0402_1005Metric; LCSC Part # C277482
C28, C50: 1nf; C_0402_1005Metric; LCSC Part # C76947
C30, C38: 56nf; C_0402_1005Metric; LCSC Part # C36911349
C31, C51: 10nf; C_0402_1005Metric; LCSC Part # C15195
C34, C44, C45: 470pf; C_0402_1005Metric; LCSC Part # C701296
C36, C53: 100nf; C_0402_1005Metric; LCSC Part # C60474
C37: 103pf; C_0402_1005Metric; LCSC Part # C327009
C39, C55: 1.5pf; C_0402_1005Metric; LCSC Part # C1552
C40, C54: 4.7pf; C_0402_1005Metric; LCSC Part # C1569
C42, C56: 1pf; C_0402_1005Metric; LCSC Part # C710646
C43, C52: 2.2nf; C_0402_1005Metric; LCSC Part # C2987940
C46: 56nF; C_0402_1005Metric; LCSC Part # C36911349
D1: LED; LED_0402_1005Metric; LCSC Part # C21260817
F1: JFC2410-1100TS; FUSC10131X330N; Manufacturer_Part_Number SF-3812TL100T-2; Mouser Part Number 652-SF-3812TL100T-2
FL2: UU9.8-10MH; UU9810MH; Manufacturer_Part_Number UU9.8-10MH; LCSC Part # C148474
H1, H2, H3, H4, H5: MountingHole; MountingHole_3.2mm_M3
IC1, IC5: NRF24L01P-R; QFN50P400X400X95-21N-D; Manufacturer_Part_Number NRF24L01P-R; Mouser Part Number 949-NRF24L01P-R
IC2: TLV3012AIDBVTG4; SOT95P280X145-6N; Manufacturer_Part_Number TLV3012AIDBVTG4; Mouser Part Number 595-TLV3012AIDBVTG4
IC3: BISS0001; SOIC127P600X160-16N; Manufacturer_Part_Number BISS0001; LCSC Part # C18164474
IC4: STM32G031K8T6TR; QFP80P900X900X160-32N; Manufacturer_Part_Number STM32G031K8T6TR; Mouser Part Number 511-STM32G031K8T6TR
J1: Battery; JST_EH_B2B-EH-A_1x02_P2.50mm_Vertical; LCSC Part # C160262
J2, J3: Conn_ARM_SWD_TagConnect_TC2030; Tag-Connect_TC2030-IDC-FP_2x03_P1.27mm_Vertical
J4, J5: Conn_01x01_Pin; TestPoint_Keystone_5010-5014_Multipurpose
L4, L7: 8.2nH; L_0402_1005Metric; LCSC Part # C84404
L5, L9: 3.9nH; L_0402_1005Metric; LCSC Part # C5452416
L6, L8: 2.7nH; L_0402_1005Metric; LCSC Part # C77108
LED1, LED2, LED3, LED4, LED5, LED6: SPMWH1228MD5WATUVK; Manufacturer_Part_Number SPMWH1228MD5WATUVK; LCSC Part # 1510-SPMWH1228MD7WATUVKTR-ND
PS1: HLK-5M05; Converter_ACDC_Hi-Link_HLK-5Mxx; LCSC Part # C209907
Q1, Q3: AO3407A; SOT95P280X125-3N; Manufacturer_Part_Number AO3407A; LCSC Part # C15155
Q2, Q4: AO3400A; SOT-23; LCSC Part # C20917
R1: 2.7K; R_0402_1005Metric; LCSC Part # C138017
R2, R5, R8, R9, R11, R16, R17, R18, R22, R40, R48, R49, R50, R51: 10k; R_0402_1005Metric; LCSC Part # C60490
R3: 1.8K; R_0402_1005Metric; LCSC Part # C163481
R4: NTC; R_0402_1005Metric
R6, R21: 22k; R_0402_1005Metric; LCSC Part # C82868
R7: 4k7; R_0402_1005Metric; LCSC Part # C105871
R10, R13, R29: 100k; R_0402_1005Metric; LCSC Part # C60491
R12: 174k; R_0402_1005Metric; LCSC Part # C4214842
R14, R26, R32, R33, R47: 1M; R_0402_1005Metric; LCSC Part # C138033
R15: 100r; R_0402_1005Metric; LCSC Part # C106232
R19: 120k; R_0402_1005Metric; LCSC Part # C60490
R20: R_Photo; R_LDR_5.0x4.1mm_P3mm_Vertical; LCSC Part # C125627
R23, R24, R25, R28, R30: 18k; R_0402_1005Metric; LCSC Part # C138044
R27, R35: 6.2k; R_0402_1005Metric; LCSC Part # C137946
R31: 2.2M; R_0402_1005Metric; LCSC Part # C203143
R34: 3.3M; R_0402_1005Metric; LCSC Part # C482174
R36: 180K; R_0402_1005Metric; LCSC Part # C25760
R37: 4.7M; R_0402_1005Metric; LCSC Part # C3013173
R38: 100R; R_0402_1005Metric; LCSC Part # C106232
R39: 470k; R_0402_1005Metric; LCSC Part # C137976
R41, R42, R43, R44, R45, R46: 33R; R_0805_2012Metric; LCSC Part # C2907220
R52: 330r; R_0402_1005Metric; LCSC Part # C2097621
RV1: Varistor; RV_Disc_D12mm_W4.5mm_P7.5mm; LCSC Part # C2839517
S1, S2, S3: 1301.9314.24; 1301931424; Manufacturer_Part_Number 1301.9314.24; Mouser Part Number 693-1301.9314.24
TP1: LDO_IN; TestPoint_Pad_D4.0mm
U1: BQ24074RGT; VQFN-16-1EP_3x3mm_P0.5mm_EP1.6x1.6mm; LCSC Part # C54313
U2: ATtiny1616-S; SOIC-20W_7.5x12.8mm_P1.27mm; LCSC Part # C614136
U3, U5, U7, U8, U9, U10, U11, U12, U13: mouse bite; mouse-bite-2mm-4mm
U4: TLV75533PDBV; SOT-23-5; LCSC Part # C404027
U6: PIS-209S; PIS209S; Manufacturer_Part_Number PIS-209S
VR1: PVG3A103C01R00; Manufacturer_Part_Number PVG3A103C01R00; Mouser Part Number 81-PVG3A103C01R00
Y1, Y2: crystal; X322516MOB4SI; Manufacturer_Part_Number X322516MOB4SI; LCSC Part # C12668

Connections:
+3.3V: BT1.1 (+), C6.2, C8.1, C50.1, C51.1, C53.1, IC5.7 (VDD_1), IC5.15 (VDD_2), IC5.18 (VDD_3), J2.1 (VCC), R7.2, R9.1, R11.1, R17.1, R18.2, R48.1, U2.1 (VCC)
/3V3: C2.2, C3.2, C5.1, C14.1, C26.2, C28.1, C31.1, C36.1, IC1.7 (VDD_1), IC1.15 (VDD_2), IC1.18 (VDD_3), IC3.1 (A), IC3.11 (VDD), IC4.4 (VDD/VDDA), J3.1 (VCC), R2.1, R19.2, R25.1, R34.2, R36.1, R41.2, R42.2, R43.2, R44.2, R45.2, R46.2, R50.2, R51.1, U4.5 (OUT)
/5V: C1.1, C10.1, PS1.4 (+Vout), U1.13 (IN)
/50ohm: C39.1, C42.1
/50ohm_: C55.1, C56.1
/CE: IC1.1 (CE), IC4.15 (PB0), R49.2
/CE_: IC5.1 (CE), R22.2, U2.13 (PC1)
/CSN: IC1.2 (CSN), IC4.10 (PA3), R50.1
/CSN_: IC5.2 (CSN), R18.1, U2.12 (PC0)
/IRQ: IC1.6 (IRQ), IC4.16 (PB1), R51.2
/IRQ_: IC5.6 (IRQ), R48.2, U2.14 (PC2)
/L: F1.1, J4.1
/LDO_IN: C12.1, Q3.3 (D), TP1.1, U4.1 (IN), U4.3 (EN)
/Led-drive: IC4.19 (PA9), R38.1
/Light-sense: IC4.8 (PA1), R19.1, R20.1
/MISO_: IC5.5 (MISO), U2.18 (PA2)
/MOSI_: IC5.4 (MOSI), U2.17 (PA1)
/N: C4.2, FL2.4, J5.1, RV1.2
/NRST: C7.1, IC4.6 (PF2-NRST), J3.3 (~RESET), R2.2
/PB0: R9.2, S1.1 (NO_1), S1.2 (NO_2), U2.15 (PC3)
/PB1: R11.2, S2.1 (NO_1), S2.2 (NO_2), U2.10 (PB1)
/PB2: R17.2, S3.1 (NO_1), S3.2 (NO_2), U2.9 (PB2)
/PIR-VO: IC4.18 (PA8), R35.1
/RESET: J2.3 (~RESET), R7.1, U2.16 (~RESET/PA0)
/SCK_: IC5.3 (SCK), U2.19 (PA3)
/SPI1_MISO: IC1.4 (MOSI), IC4.13 (PA6)
/SPI1_MOSI: IC1.5 (MISO), IC4.14 (PA7)
/SPI1_SCK: IC1.3 (SCK), IC4.12 (PA5)
/SWCLK: IC4.25 (PA14-BOOT0), J3.4 (SWCLK), R8.1
/SWDIO: IC4.24 (PA13), J3.2 (SWDIO)
/SYS: C9.2, Q3.2 (S), R5.2, U1.5 (EN2), U1.10 (OUT), U1.11 (OUT)
/V_Bat: C11.1, IC2.6 (V+), Q1.3 (D), R12.2, U1.2 (BAT), U1.3 (BAT)
GND: C1.2, C2.1, C3.1, C5.2, C7.2, C9.1, C10.2, C11.2, C12.2, C14.2, C16.2, C21.1, C22.1, C23.2, C25.2, C26.1, C28.2, C30.1, C31.2, C35.1, C36.2, C40.2, C41.2, C42.2, C43.2, C44.1, C45.2, C46.1, IC1.8 (VSS_1), IC1.14 (VSS_2), IC1.17 (VSS_3), IC1.20 (VSS_4), IC2.2 (V-), IC3.7 (VSS), IC4.5 (VSS/VSSA), J1.2, J3.5 (GND), PS1.3 (-Vout), Q2.2 (S), Q4.2 (S), R1.1, R3.1, R4.2, R8.2, R10.2, R13.1, R16.2, R20.2, R21.2, R24.2, R33.2, R40.2, R49.1, U1.4 (~CE), U1.6 (EN1), U1.8 (VSS), U1.14 (TMR), U1.17 (VSS), U4.2 (GND), U6.3 (G), Y2.2 (GND_1), Y2.4 (GND_2)
GNDREF: BT1.2 (-), C6.1, C8.2, C47.2, C48.2, C49.2, C50.2, C51.2, C52.2, C53.2, C54.2, C56.2, D1.1 (K), IC5.8 (VSS_1), IC5.14 (VSS_2), IC5.17 (VSS_3), IC5.20 (VSS_4), J2.5 (GND), R6.2, R22.1, S1.3 (COM_1), S1.4 (COM_2), S2.3 (COM_1), S2.4 (COM_2), S3.3 (COM_1), S3.4 (COM_2), U2.20 (GND), Y1.2 (GND_1), Y1.4 (GND_2)
unnamed: C4.1, F1.2, FL2.1, RV1.1
unnamed: C19.2, R27.2
unnamed: C21.2, R23.2, R25.2
unnamed: C35.2, R30.2
unnamed: C39.2, L5.2
unnamed: C55.2, L9.2
unnamed: D1.2 (A), R52.1
unnamed: IC1.12 (ANT1), L4.2, L6.1
unnamed: IC1.13 (ANT2), L4.1, L5.1
unnamed: C16.1, IC1.19 (DVDD)
unnamed: IC1.16 (IREF), R21.1
unnamed: C40.1, C43.1, IC1.11 (VDD_PA), L6.2
unnamed: C25.1, IC1.10 (XC1), R26.1, Y2.1 (CRYSTAL_1)
unnamed: C23.1, IC1.9 (XC2), R26.2, Y2.3 (CRYSTAL_2)
unnamed: IC2.3 (IN+), R12.1, R13.2, R14.2
unnamed: IC2.4 (IN-), IC2.5 (REF)
unnamed: IC2.1 (OUT), R14.1, R15.1
unnamed: C30.2, C34.2, IC3.14 (1IN+), R28.1
unnamed: C34.1, C38.2, IC3.15 (1IN-), R30.1, R32.1
unnamed: C19.1, C38.1, IC3.16 (1OUT), R32.2
unnamed: C37.2, IC3.13 (2IN-), R29.1, R31.1, VR1.2 (WIPER)
unnamed: C37.1, IC3.12 (2OUT), R31.2
unnamed: IC3.10 (IB), R33.1
unnamed: C44.2, IC3.4 (RC1), R39.1
unnamed: C46.2, IC3.5 (RC2), R37.1
unnamed: IC3.3 (RR1), R39.2
unnamed: IC3.6 (RR2), R37.2
unnamed: C41.1, IC3.9 (VC), R34.1
unnamed: IC3.2 (VO), R35.2
unnamed: C45.1, IC3.8 (VREF/~RESET), R36.2
unnamed: IC5.12 (ANT1), L7.2, L8.1
unnamed: IC5.13 (ANT2), L7.1, L9.1
unnamed: C47.1, IC5.19 (DVDD)
unnamed: IC5.16 (IREF), R6.1
unnamed: C52.1, C54.1, IC5.11 (VDD_PA), L8.2
unnamed: C49.1, IC5.10 (XC1), R47.1, Y1.3 (CRYSTAL_2)
unnamed: C48.1, IC5.9 (XC2), R47.2, Y1.1 (CRYSTAL_1)
unnamed: J1.1, Q1.2 (S)
unnamed: LED1.2 (A), R41.1
unnamed: LED1.1 (K), LED2.1 (K), LED3.1 (K), LED4.1 (K), LED5.1 (K), LED6.1 (K), Q4.3 (D)
unnamed: LED2.2 (A), R42.1
unnamed: LED3.2 (A), R43.1
unnamed: LED4.2 (A), R44.1
unnamed: LED5.2 (A), R45.1
unnamed: LED6.2 (A), R46.1
unnamed: FL2.2, PS1.1 (AC/L)
unnamed: FL2.3, PS1.2 (AC/N)
unnamed: Q1.1 (G), R10.1
unnamed: Q2.3 (D), Q3.1 (G), R5.1
unnamed: Q2.1 (G), R15.2, R16.1
unnamed: Q4.1 (G), R38.2, R40.1
unnamed: R1.2, U1.12 (ILIM)
unnamed: R3.2, U1.16 (ISET)
unnamed: R4.1, U1.1 (TS)
unnamed: R52.2, U2.5 (PA7)
unnamed: R23.1, U6.1 (D)
unnamed: C22.2, R24.1, R28.2, U6.2 (S)
unnamed: R27.1, R29.2, VR1.1 (CCW)

Notes on the sheet:
REMOTE/TRANSMITTER SCHEMATICS
PIR (BISS001) MOTION SENSOR
3V3 LDO
SWD TAG CONNECT
BQ24074RGT BAT CHARGING SCHEMATICS
STM32G031K8T6TR
RF Module - nRF24L01
USER INPUT BUTTONS
1 For a charge current of 500ma to battery ISET - Charge Current = 500 mA RISET = KISET / ICHG = 890 / 0.5 = 1780 Ω = 1.8 kΩ standard value 2 Max input current to IC (to prevent excess heat at the HLK-5m05) ILIM - Input Current Cap = 600 mA RILIM = KILIM / IIN-MAX = 1610 / 0.6 = 2683 Ω = 2.7 kΩ sta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
COMPARATOR NETWORK FOR LOW BAT SWITCHING
SIX LIGHTING LED ARRAY
LIGHT SENSING
ATtiny1616-S
Using a 174 kΩ/100 kΩ divider with a 1 MΩ feedback resistor, I implemented hysteresis in the comparator. This shifts the effective threshold so the circuit turns OFF at ~3.4 V and only turns ON again at ~3.6 V, ensuring clean, stable behavior without oscillation.
100-240VAC INPUT TO 5V 1A

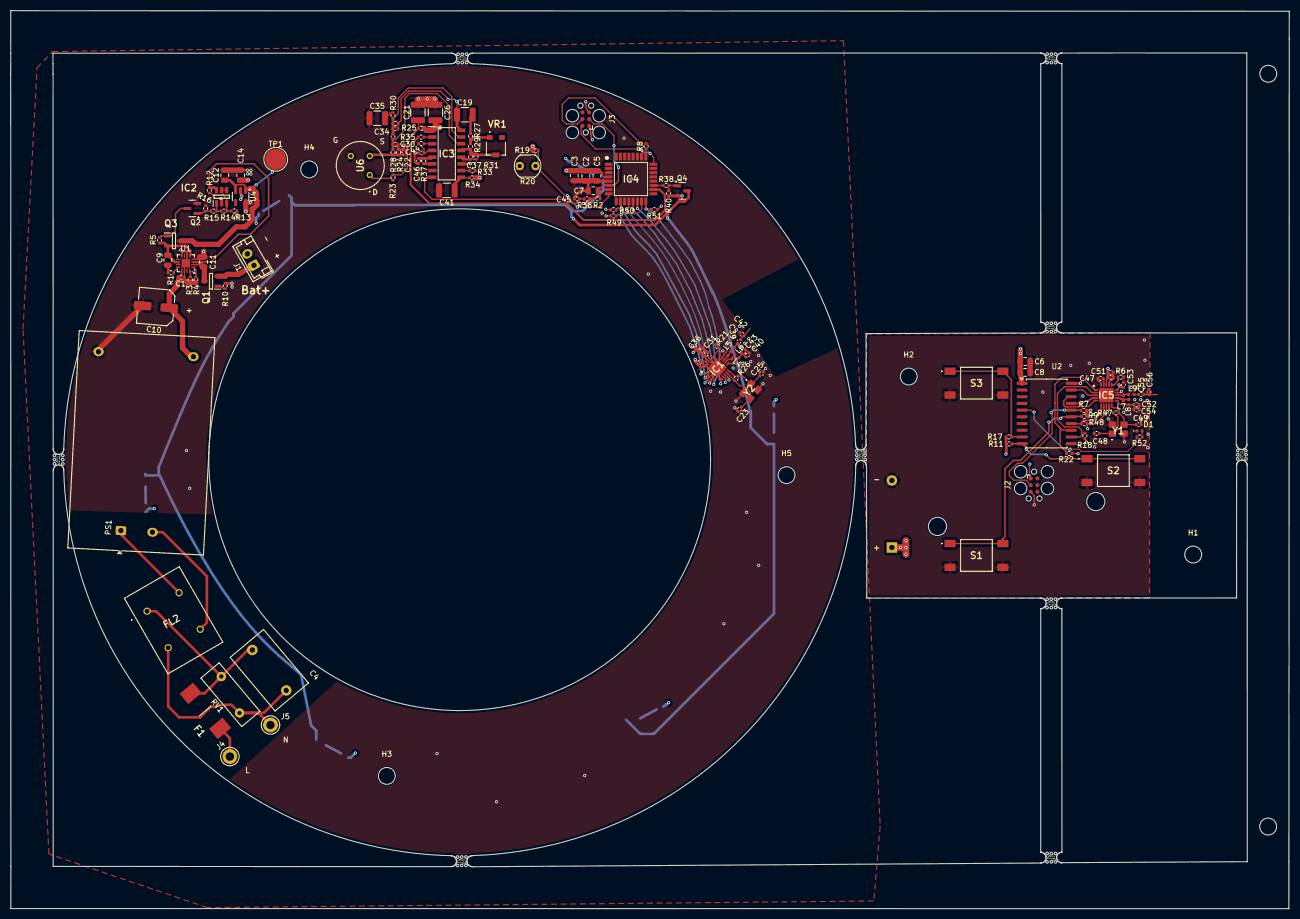
[picture p32: board Night light PCB.kicad_pcb from above]

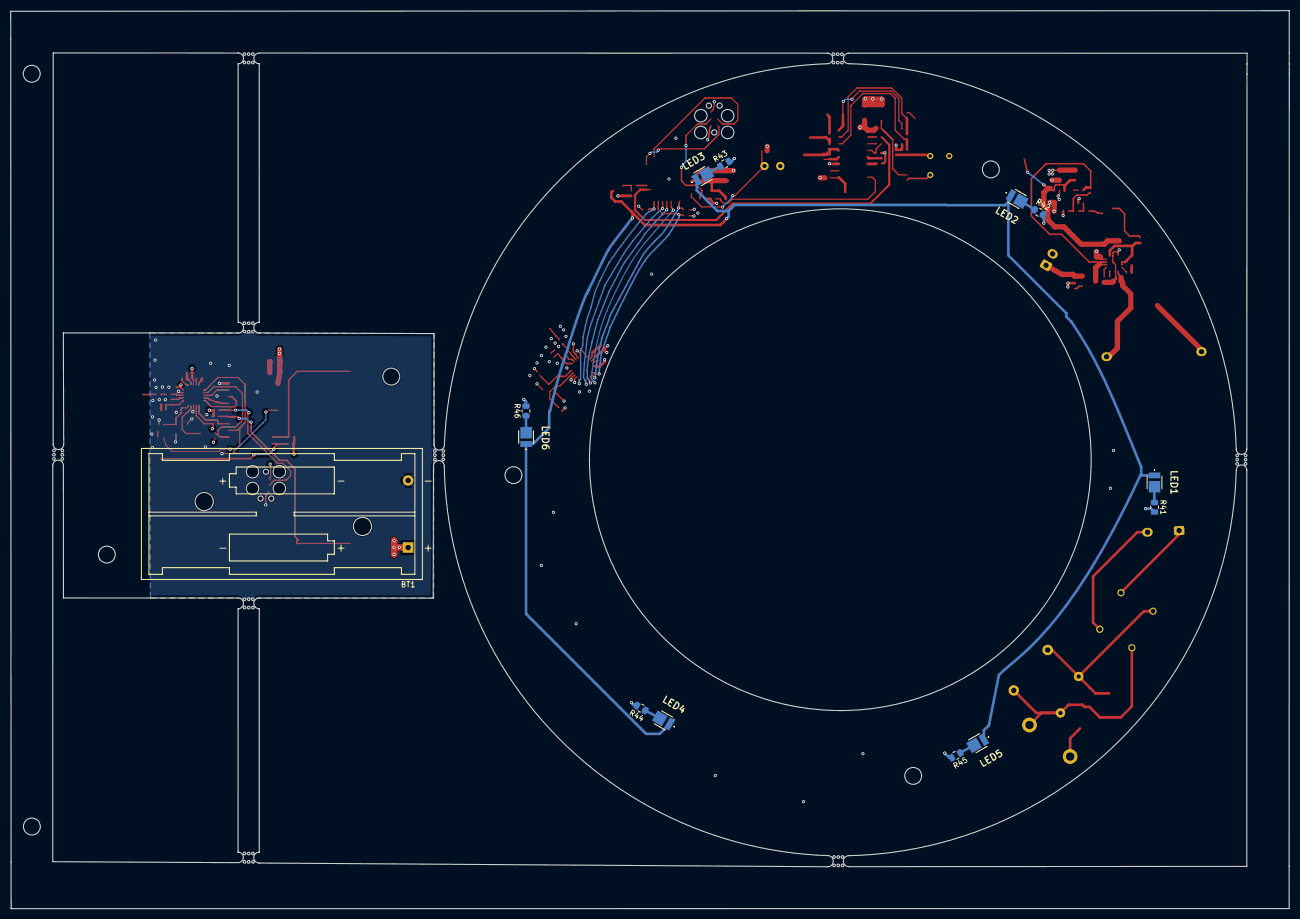
[picture p33: board Night light PCB.kicad_pcb from below]

Board: 4 copper layers, 242.1 x 170.0 mm, 155 parts (13 on the bottom side), 92 nets.
