oyeniyihakeem08-blip/Night-light-PCB-prototype/Firmware source file/Smart Remote/generate_hex.py

Import("env")

env.AddPostAction(
    "$BUILD_DIR/${PROGNAME}.elf",
    env.VerboseAction(
        " ".join([
            "$OBJCOPY",
            "-O", "ihex",
            "-R", ".eeprom",
            "$BUILD_DIR/${PROGNAME}.elf",
            "$BUILD_DIR/${PROGNAME}.hex"
        ]),
        "Building HEX file"
    )
)
