oyeniyihakeem08-blip/Night-light-PCB-prototype/(commit log)

2026-10-24 Update gitignore to track only project sources and folders
2026-10-24 Update KiCad project settings
2026-10-24 Move gerbers, production and design files into one folder
2026-10-24 Add README and schematic image
2026-10-24 Add README, images and schematic
